arturoherediam/mvp-monitoreo-sites/hardware/carcasas/README.md

# Carcasas

- **Responsable:** Diego. Tareas 3.1 a 3.4.
- **Propósito:** alojar y proteger el nodo rack, las PCB de sensores y el nodo ambiente.
- **Decisión (23 oct):** se usan **carcasas genéricas compradas** y se adaptan a las PCB finales (cortes para USB, OLED y sensores; fijación de las PCB). No se diseñan ni se imprimen. La Orange Pi usa la caja de acrílico que vino con la placa; su antena (conector u.FL) debe quedar fija y lejos de metal (ver `gateway/orangepi/README.md`).

## Contenido de esta carpeta

En este directorio se documentan las carcasas compradas y su adaptación:

- **Dimensiones y medidas:** cotas generales, fijación de las PCB y aberturas de ventilación/conectores.
- **Modelo comprado y adaptaciones:** proveedor, modelo y medidas de cada carcasa, y los cortes o fijaciones hechos.
- `imagenes/`: fotografías de las carcasas compradas, adaptadas y ensambladas.
