arturoherediam/mvp-monitoreo-sites/hardware/pcb-sensores/README.md

# pcb-sensores

Responsable: Sebastián. Tareas 2.2.

Contenido: SHT41, espacio para el YG1006 y puerto de conexión al nodo rack.

Entregable: proyecto de diseño con DRC sin errores y archivos de fabricación en esta carpeta. Ver `docs/acuerdos/hardware.md`.
