arturoherediam/mvp-monitoreo-sites/docs/acuerdos/decisiones-abiertas.md

# Decisiones abiertas

| Fecha límite | Decisión | Responsable |
| --- | --- | --- |
| 7 oct | Conector y cable entre PCB de sensores y nodo rack | Sebastián |
| 9 oct | Flama con QoS 0: repetir cada segundo mientras esté activa | Luis Mario |
| 13 oct | Valores CF=1 o atmosféricos del PMS5003 (durante la tarea 6.2) | Priscila |
| 16 oct | Confirmar con los organizadores que se permite llama abierta | Luis Mario |
| 19 oct | Plazo real de fabricación de las PCB (supuesto: 8 días hábiles) | Diego |
| 22 oct | Protocolo de la prueba de flama con encendedor | Luis Mario |
| 6 nov | Canal WiFi del hotspot, medido en el recinto | Arturo |
| 9 nov | Umbral inicial del índice de dosis | Priscila |

Al cerrar una decisión, se anota aquí el resultado y se actualiza el documento que corresponda.

## Trabajo futuro (fuera del MVP)

| Tema | Qué falta | Dónde está documentado |
| --- | --- | --- |
| MQTT sin TLS | Cifrar el tráfico con TLS en el puerto 8883 | `docs/acuerdos/seguridad-y-secretos.md` |
