arturoherediam/mvp-monitoreo-sites/tools/README.md

# Herramientas

| Archivo | Para qué sirve |
| --- | --- |
| `validar_ejemplos.py` | Valida los ejemplos JSON contra los esquemas y comprueba el punto de rocío (Magnus). Requiere `pip install jsonschema` |
| `configurar_repo.sh` | Primer push, seguridad y protección de `main` (lo corre Arturo una sola vez) |
| `crear_issues.py` y `issues_wbs.csv` | Crean un issue por tarea del WBS con `gh` |
| `simulador/` | Simulador de nodos (tarea 4.2, Arturo) |
