arturoherediam/mvp-monitoreo-sites/firmware/nodo-ambiente/README.md

# Firmware del nodo ambiente

Proyecto PlatformIO del nodo `ambiente`. Usa la librería común de `../common`.

- Copia `include/secrets.example.h` a `include/secrets.h` antes de compilar.
- Debe publicar el JSON de `docs/acuerdos/contrato-json.md`; pruébalo con `tools/validar_ejemplos.py` y el simulador.
- Tareas: 6.2 a 6.4 (ver `docs/plan/wbs.md`).
