arturoherediam/mvp-monitoreo-sites/gateway/db/README.md

# db

Esquema de SQLite del histórico (tarea 4.8): modo WAL con `synchronous=NORMAL` y escritura agrupada cada 10 a 30 s.
