arturoherediam/mvp-monitoreo-sites/gateway/scripts/README.md

# scripts

Scripts del gateway: hotspot con `nmcli`, ICS en la laptop y respaldo con el celular (tareas 4.5 y 4.9).
