arturoherediam/mvp-monitoreo-sites/docs/acuerdos/red-y-gateway.md

# Red y gateway

La Orange Pi Zero 3 es el gateway: crea el hotspot al que se conectan los nodos, corre Mosquitto con ACL, Node-RED y SQLite en microSD. Es una solución válida para el MVP, no para producción.

| Elemento | Acuerdo |
| --- | --- |
| Hotspot de los nodos | Creado con **hostapd** en `wlan0` de la Orange Pi: WPA2, 2.4 GHz (el ESP32 no usa 5 GHz); `systemd-networkd` da las IP por DHCP. Subred `10.42.0.0/24`, gateway `10.42.0.1`. Se cambió de `nmcli` a hostapd el 22 oct: la imagen Armbian mínima no trae NetworkManager y en esta placa el hotspot con `nmcli` fallaba con WPA2 (foros de Armbian, 2024). Ver [gateway/orangepi](../../gateway/orangepi/README.md) |
| Enlace Orange Pi y laptop | Ethernet con *Internet Connection Sharing* (ICS) en la laptop Ubuntu 26.04. Subred `10.42.1.0/24`: laptop `10.42.1.1`, Orange Pi `10.42.1.2` fija en `end0` (conserva también el DHCP del ICS para la ruta a internet y el DNS). Con un cable normal: el cable cruzado que se probó no daba enlace |
| Subredes | Separadas a propósito: si ambas fueran `10.42.0.0/24` chocarían el hotspot y el ICS |
| Respaldo de internet | La laptop se conecta **por Wi-Fi** al hotspot del celular; el celular no se conecta directo a la Orange Pi. El tethering por USB no sirve sin cambios: la regla de reenvío de ufw solo permite salir por el Wi-Fi de la laptop. Probado el 30 oct |
| Canal WiFi | Se escanea en el recinto y se fija 1, 6 u 11 antes de las pruebas de integración |
| VPN | Apagada en la laptop y en la Orange Pi durante desarrollo y demo; rompió el hotspot en el prototipo |
| Sistema de la Orange Pi | Armbian 26.11 *rolling* (Debian 13 Minimal, kernel 6.18.57). Se actualiza una vez y se congela el kernel después del hotspot |
| Hora | La laptop es servidor de hora (chrony, `allow 10.42.1.0/24`); la Orange Pi la toma con `systemd-timesyncd` (`NTP=10.42.1.1`). Así la hora es correcta aunque no haya internet |
| Acceso a la Orange Pi | SSH solo con llave, usuario `arturo` con `sudo`, sin root ni contraseñas |
| SQLite | Modo WAL con `synchronous=NORMAL`; escritura agrupada cada 10 a 30 s para cuidar la microSD |
| Índices de mantenimiento | Reemplazan al índice de dosis (ANSI/ISA-71.04 mide gases corrosivos con cupones, y no los medimos). Se calculan en Node-RED con límites ASHRAE, el modelo de Peck y viento de Open-Meteo; dan riesgo relativo, no probabilidad de falla. La demo usa un modo acelerado y se declara al jurado. Ver [indices-mantenimiento.md](indices-mantenimiento.md) |

## ICS en la laptop (tarea 4.9)

Reemplazar `<interfaz>` por la interfaz Ethernet que muestre `nmcli device` y `<wifi>` por la inalámbrica:

```bash
nmcli device
nmcli connection add type ethernet ifname <interfaz> con-name ics-pi \
  ipv4.method shared ipv4.addresses 10.42.1.1/24 ipv6.method disabled
nmcli connection up ics-pi
# Solo si ufw está activo:
sudo ufw allow in on <interfaz> to any port 67 proto udp
sudo ufw allow in on <interfaz> to any port 53
sudo ufw allow in on <interfaz> to any port 123 proto udp   # hora (chrony)
sudo ufw route allow in on <interfaz> out on <wifi>
```

Hora en la laptop (servidor para la Orange Pi):

```bash
sudo apt install -y chrony
echo "allow 10.42.1.0/24" | sudo tee /etc/chrony/conf.d/mvp-gateway.conf
sudo systemctl restart chrony
```

### Estado aplicado y pruebas (30 oct)

En la laptop de Arturo: `ics-pi` en el adaptador USB-RJ45 `enx00e04c69083f`, `10.42.1.1/24`, modo `shared`, sin IPv6 y con conexión automática; reenvío IPv4 activo y NAT (masquerade) de `10.42.1.0/24` hacia cualquier interfaz; ufw con DHCP, DNS y hora desde el adaptador y reenvío del adaptador a `wlp3s0`; chrony activo con `allow 10.42.1.0/24`.

| Prueba | Resultado |
| --- | --- |
| a. Laptop en su Wi-Fi normal | La Orange Pi tiene internet, DNS, hora sincronizada, Open-Meteo (HTTP 200) y Telegram |
| b. Laptop en el hotspot del celular (por Wi-Fi) | Funciona sin tocar la Orange Pi. El primer aviso de Telegram justo después del cambio de red falló (`ETIMEDOUT`); los siguientes llegaron |
| c. Reiniciar la laptop | `ics-pi` vuelve solo; la Orange Pi recupera internet y hora. Mientras tanto los nodos, el dashboard y el histórico siguen sin huecos |
| d. Sin internet | Nodos, dashboard, histórico y hotspot siguen; solo fallan viento y Telegram, de forma controlada, y se recuperan al volver internet |

**Telegram sin internet:** desde el 30 oct los avisos esperan en una cola y se reintentan (15 s, 1 min y cada 5 min, hasta 2 h); los que salen tarde llevan **[retrasado, HH:MM]**. Ver [indices-mantenimiento.md](indices-mantenimiento.md#alertas-por-telegram).

Usar un **cable Ethernet normal** entre la laptop y la Orange Pi, con la VPN apagada y el hotspot de la laptop apagado (mismo nombre e IP que el de la Orange Pi: nunca los dos a la vez).

## Topics MQTT

| Topic | Quién publica | Quién lee |
| --- | --- | --- |
| `site/datos` | `nodo_rack`, `nodo_ambiente` | `dashboard` |
| `site/estado/<node_id>` (retenido) | el nodo dueño, y su LWT | `dashboard` |
