arturoherediam/mvp-monitoreo-sites/(list of files, drawings)

Other design files:
hardware/altium/Nodo_Ambiente_pcb.PcbDoc
hardware/altium/Nodo_rack.SchDoc
hardware/altium/Nodo_rack_pcb.PcbDoc
hardware/altium/Nodo_Sensores.SchDoc
hardware/altium/Nodo_Sensores_pcb.PcbDoc
