arturoherediam/mvp-monitoreo-sites/firmware/nodo-ambiente/include/secrets.example.h

#pragma once
// Copia este archivo a secrets.h (ignorado por Git) y llena los valores desde 1Password.
// NUNCA subas secrets.h. Los valores de abajo son falsos.
#define WIFI_SSID      "CAMBIAR"
#define WIFI_PASSWORD  "CAMBIAR"
#define MQTT_HOST      "10.42.0.1"
#define MQTT_PORT      1883
#define MQTT_USER      "nodo_ambiente"
#define MQTT_PASSWORD  "CAMBIAR"
#define NODE_ID        "amb-01"   // único por placa
