arturoherediam/mvp-monitoreo-sites/(commit log)

2026-10-06 chore: estructura base del repositorio, acuerdos y ejemplos JSON
    [issues_wbs.csv]
2026-10-06 fix: usuario de GitHub de Sebastián en CODEOWNERS (#1)
2026-10-07 feat(gateway): flujo Node-RED 4.1 y conf de Mosquitto corregida (#47)
2026-10-08 feat: simulador de nodos (4.2) y aclaración de flama y seq en el contrato (#48)
    * docs: aclarar regla de flama (estado) y uso de seq en el contrato
    * feat(tools): simulador de nodos con escenarios (4.2)
2026-10-08 docs: código de error sht41_timeout del nodo ambiente y ejemplo (#49)
2026-10-09 feat: libreria comun con punto de rocio, tasa de cambio, JSON del contrato y MQTT con LWT
2026-10-09 feat: proyecto PlatformIO del nodo ambiente con pruebas de la libreria comun
2026-10-11 fix: seq empieza en 1 al arrancar, segun el contrato
2026-10-11 refactor: el nodo ambiente usa Contrato y MqttNodo de la libreria comun
2026-10-16 feat(gateway): índices de mantenimiento, brisa marina y avisos por Telegram (4.7) (#52)
    Reemplaza el índice de dosis (ISA-71.04) por seis índices de mantenimiento con límites ASHRAE y el modelo de Peck, viento de Open-Meteo y avisos por Telegram con la acción a tomar. Página Mantenimiento con mosaicos en vivo, bloque Atender ahora, eventos y simulación de 9 fases. Subidas rápidas por episodio (todo el rack o local) y aviso de más de 32 °C. 207 pruebas automáticas; probado en la laptop el 16 oct.
    Claude-Session: https://claude.ai/code/session_01ExZRwtU3z75sBbYtAXJwJ4
2026-10-21 chore: registra compra de sensor de flama y de sensor de temperatura
2026-10-22 docs(gateway): Orange Pi con sistema base (4.5 en curso); hotspot con hostapd (#56)
    Armbian Debian 13 mínimo, IP fija 10.42.1.2 en end0, hora desde la laptop, SSH solo con llave. Cambia el acuerdo del hotspot de nmcli a hostapd: la imagen no trae NetworkManager y nmcli fallaba con WPA2 en esta placa.
    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
2026-10-23 feat: monitor serie con estado de envio y de sensores; actualiza README del nodo ambiente
2026-10-25 chore: reglas de Git para archivos de Altium Designer
2026-10-25 hw: esquemáticos del nodo rack, sensores y ambiente
2026-10-25 hw: PCB del nodo rack y de sensores
2026-10-25 hw: revisión y cierre de esquemáticos y PCB de rack y sensores
2026-10-25 hw: diseño completo de la PCB del nodo ambiente
2026-10-25 hw: archivos de fabricación, esquemáticos PDF y vistas 3D de las 3 PCB
2026-10-25 docs(hw): estructura de hardware, BOM por placa y autoría de las PCB
2026-10-25 docs(hw): corrige pinout I2C de nodo ambiente (SDA=21, SCL=22 sin cambios)
2026-10-30 docs(gateway): hotspot de la Orange Pi con hostapd y DHCP de networkd (4.5) (#59)
2026-10-30 [4.6] Gateway en la Orange Pi: Mosquitto, firewall y Node-RED (#60)
    * docs(gateway): Mosquitto, firewall y Node-RED 5 en la Orange Pi (4.6)
    * fix(gateway): vigilancia del hotspot y Bluetooth apagado por caídas silenciosas del UWE5622
    * fix(gateway): la vigilancia del hotspot cuenta dispositivos con hostapd_cli (iw station dump siempre da 0)
    * docs(gateway): la caída del hotspot fue la antena; prueba larga sin reinicios
2026-10-30 feat(gateway): histórico en SQLite con página de 24 h y 7 días (4.8) (#61)
2026-10-30 docs(gateway): ICS, respaldo por el celular, revisión del gateway y lista antes de presentar (4.9) (#62)
2026-10-30 fix: Telegram con cola y reintentos; revisar-gateway.sh cuenta solo la última hora (#63)
2026-11-05 docs: README actualizado y estadística de lenguajes sin las pruebas (#64)
2026-11-10 Actualizar pines y canales I2C para el PCB final (#65)
    Se ajustan las constantes de configuración en src/main.cpp para que
    coincidan con el esquemático del PCB final:
    - PIN_SDA: 21 -> 22
    - PIN_SCL: 22 -> 21
    - PIN_FLAMA: 34 -> 18
    - CANAL_B: 0 -> 3
    - CANAL_A sin cambio (2)
    Solo se hicieron los cambios requeridos; no se modificó ninguna otra
    parte del código.
2026-11-10 docs(plan): carcasas compradas y adaptadas en lugar de diseño CAD e impresión 3D (#66)
2026-11-10 docs: pines del PCB final en el nodo rack; responsables de 7.4 y 8.2 a 8.5 (8.5 solo stand) (#67)
2026-11-10 feat(indices): umbrales teóricos con fuente (6.5); responsables de 6.5 y 7.5 (#68)
2026-11-13 feat(pruebas): script de la prueba de estabilidad de 24 h con corte de energía (7.6) (#69)
